nanase/YMF825-musicBOX/README.md

YMF825 musicBOX
==============

## 概要

Arduino Nano と YMF825Board を使って電子オルゴールを作るための回路とスケッチです。

## 基板一覧

バージョン | 開発時期
----------|---------------
[Ver.1.0a](./1.0a_2018.09/)<br>[Ver.1.0ka](./1.0a_2018.09/) | 2018.09

## ライセンス

### ソフトウェア

[**MIT LICENSE**](./LICENSE)

### ハードウェア

1. このリポジトリで公開されている基板情報、回路に限り、誰でも無償で無制限で扱ってよい。
2. このリポジトリで公開されている基板情報、回路の設計者および公開者はなんら責任を負わない。
