nanase/YMF825-musicBOX/1.1_2018.10/pdf/schematic.pdf

1

2

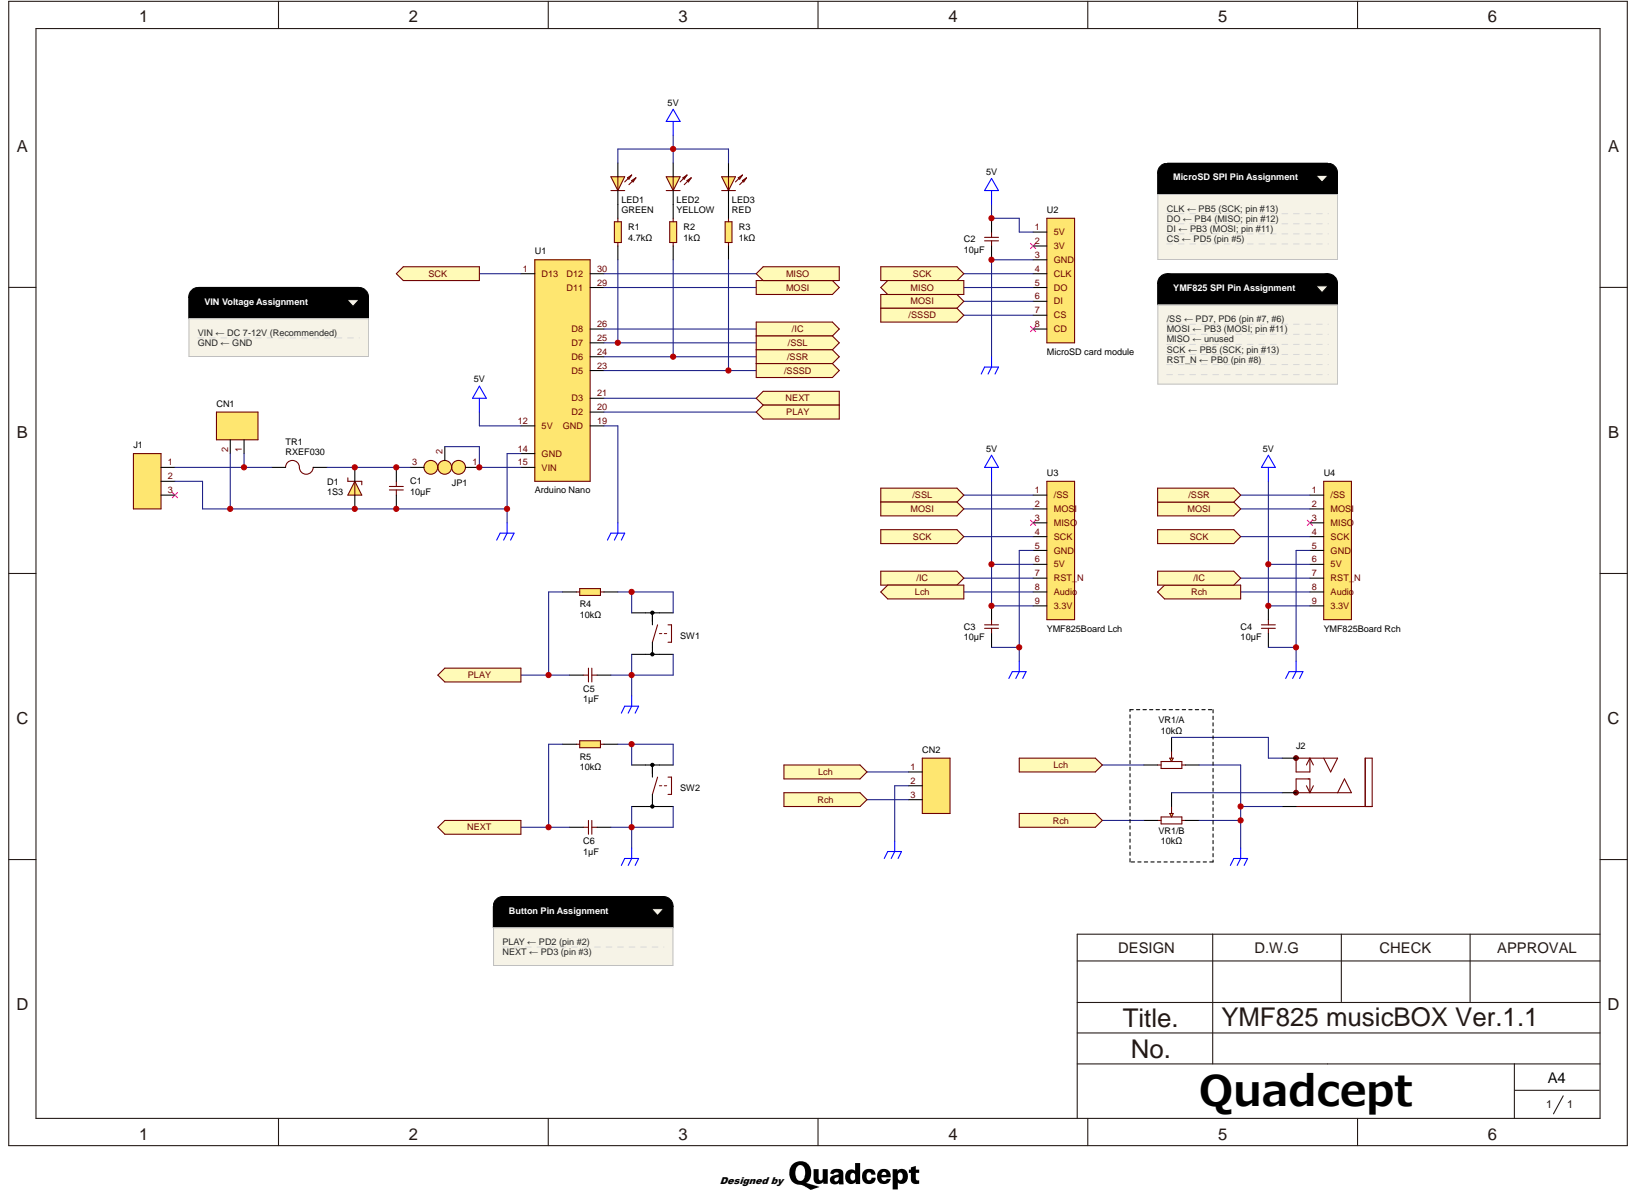
[picture p10: page 1]

MicroSD SPI Pin Assignment

Title. | YMF825 musicBOX Ver.1.1
No.
Quadcept | A4
