nanase/YMF825-musicBOX/1.0a_2018.09/pdf/schematic.pdf

1

2

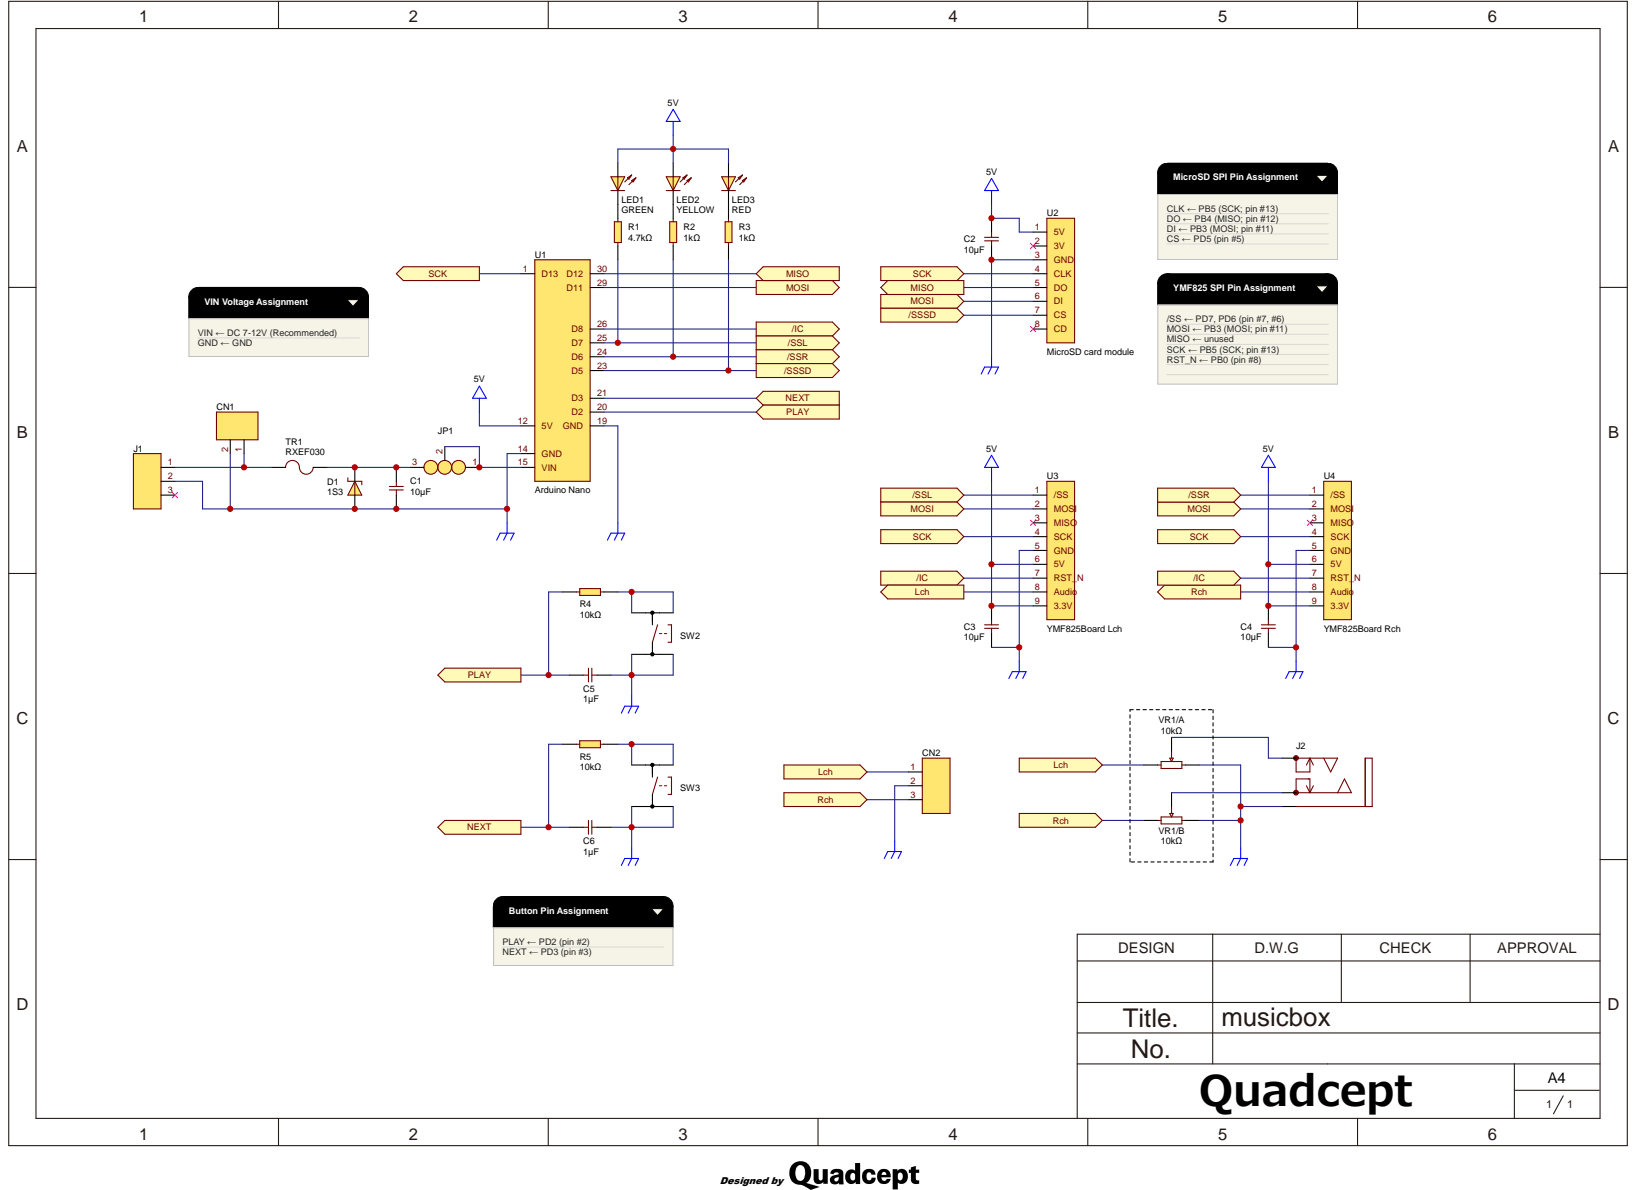
[picture p11: page 1]

MicroSD SPI Pin Assignment

Title. | musicbox
No.
Quadcept | A4
