nanase/YMF825-musicBOX/1.1_2018.10/pdf/pcb.pdf

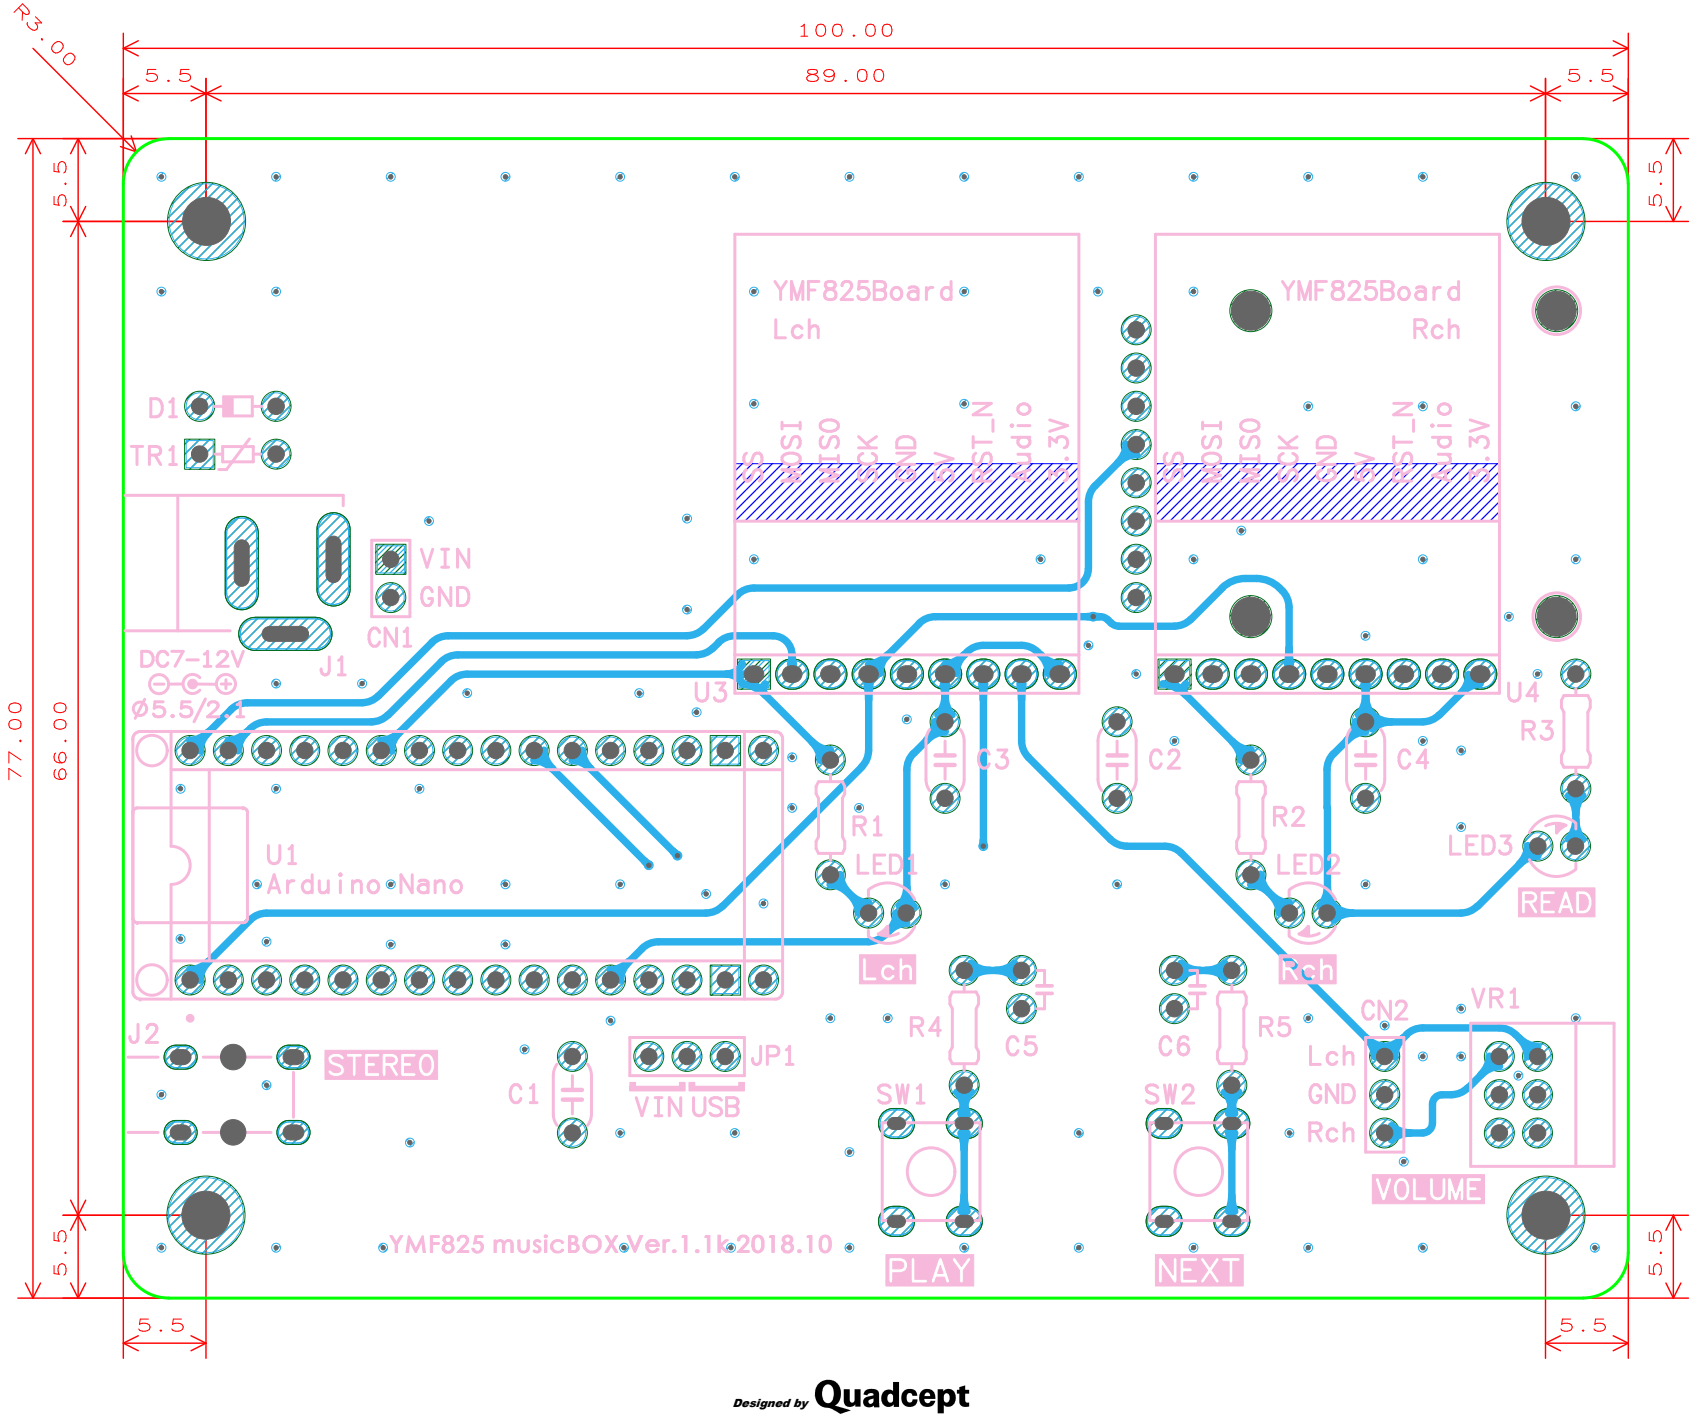
[picture p12: page 1]
Designed by

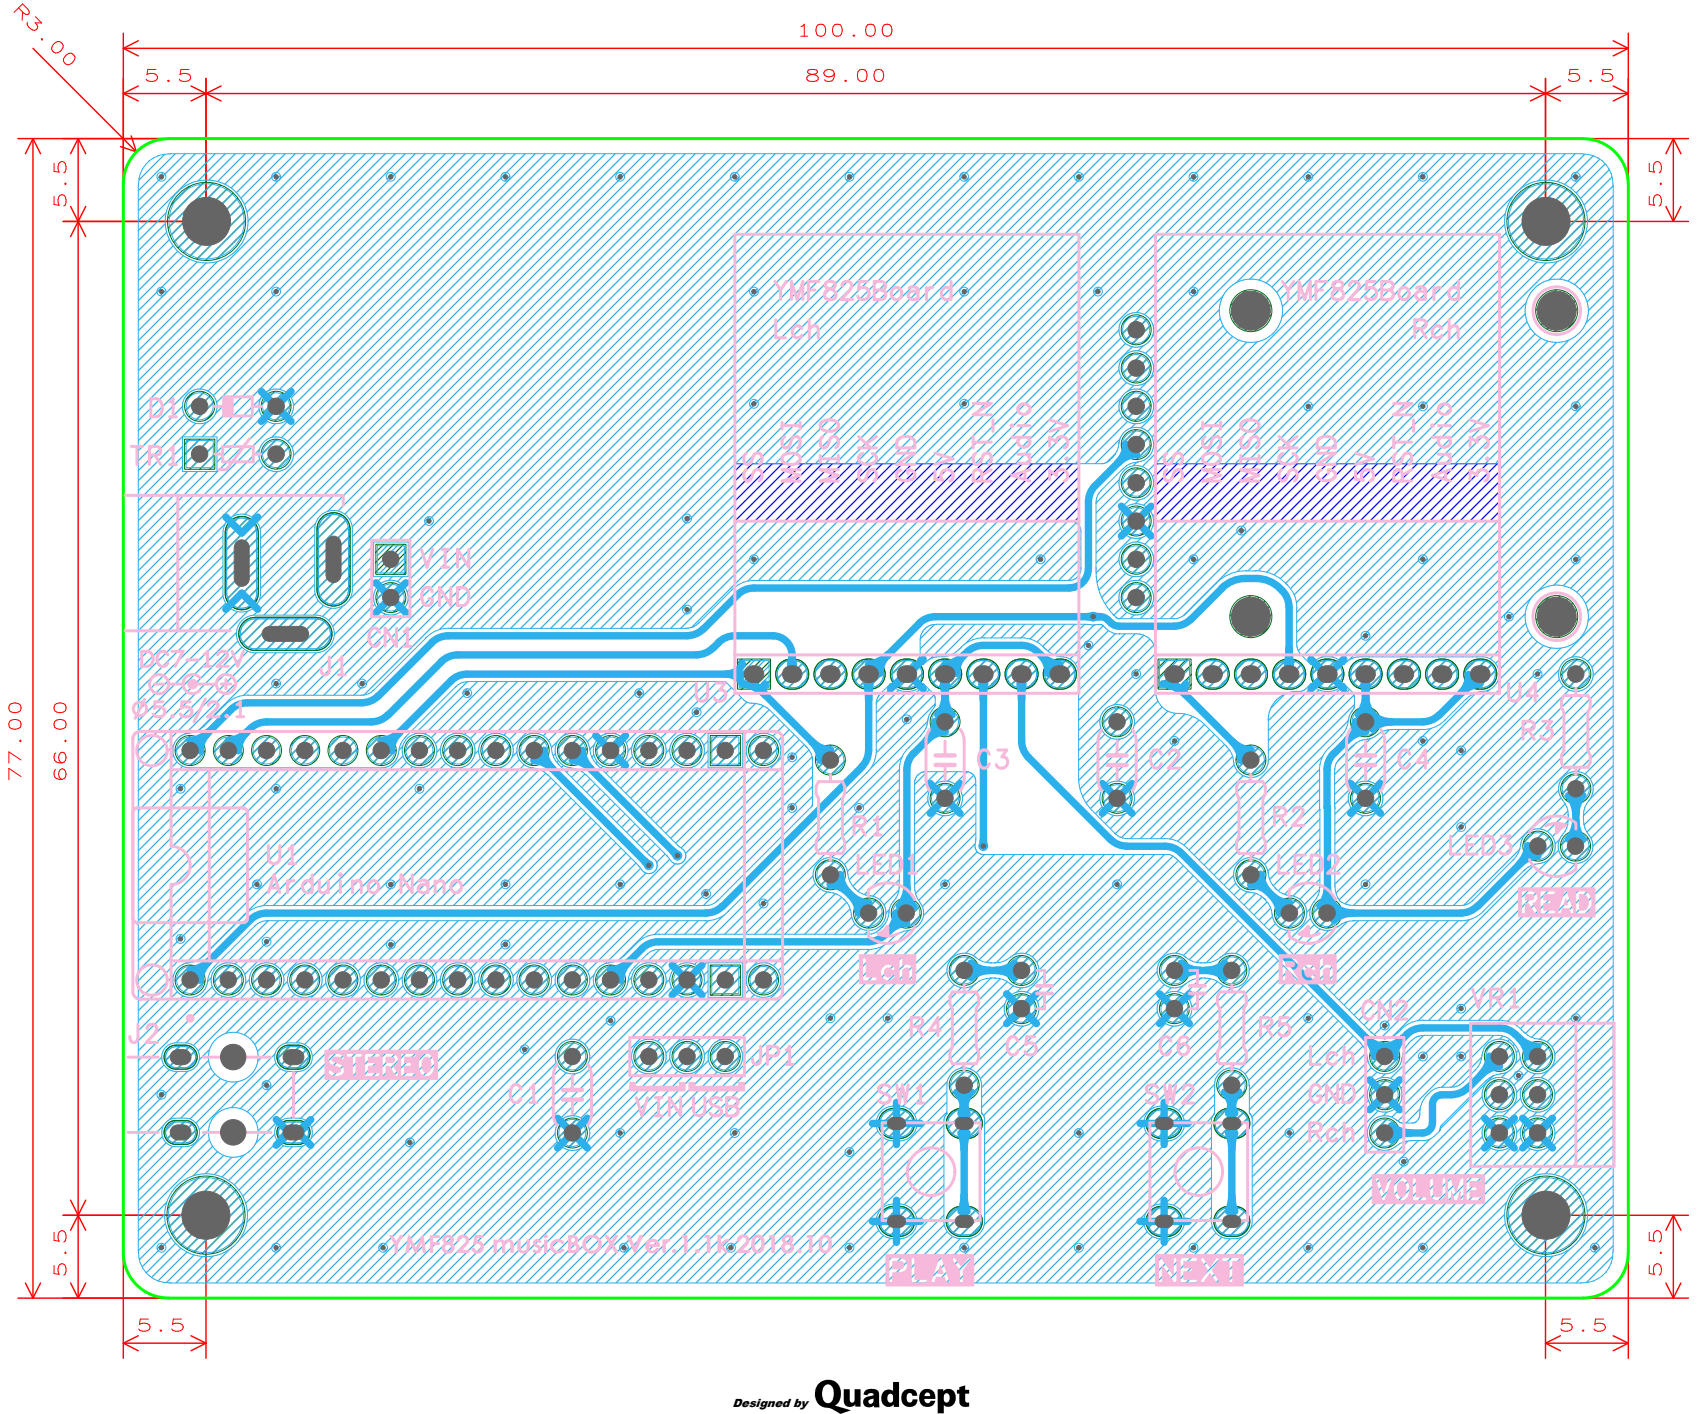
[picture p13: page 2]

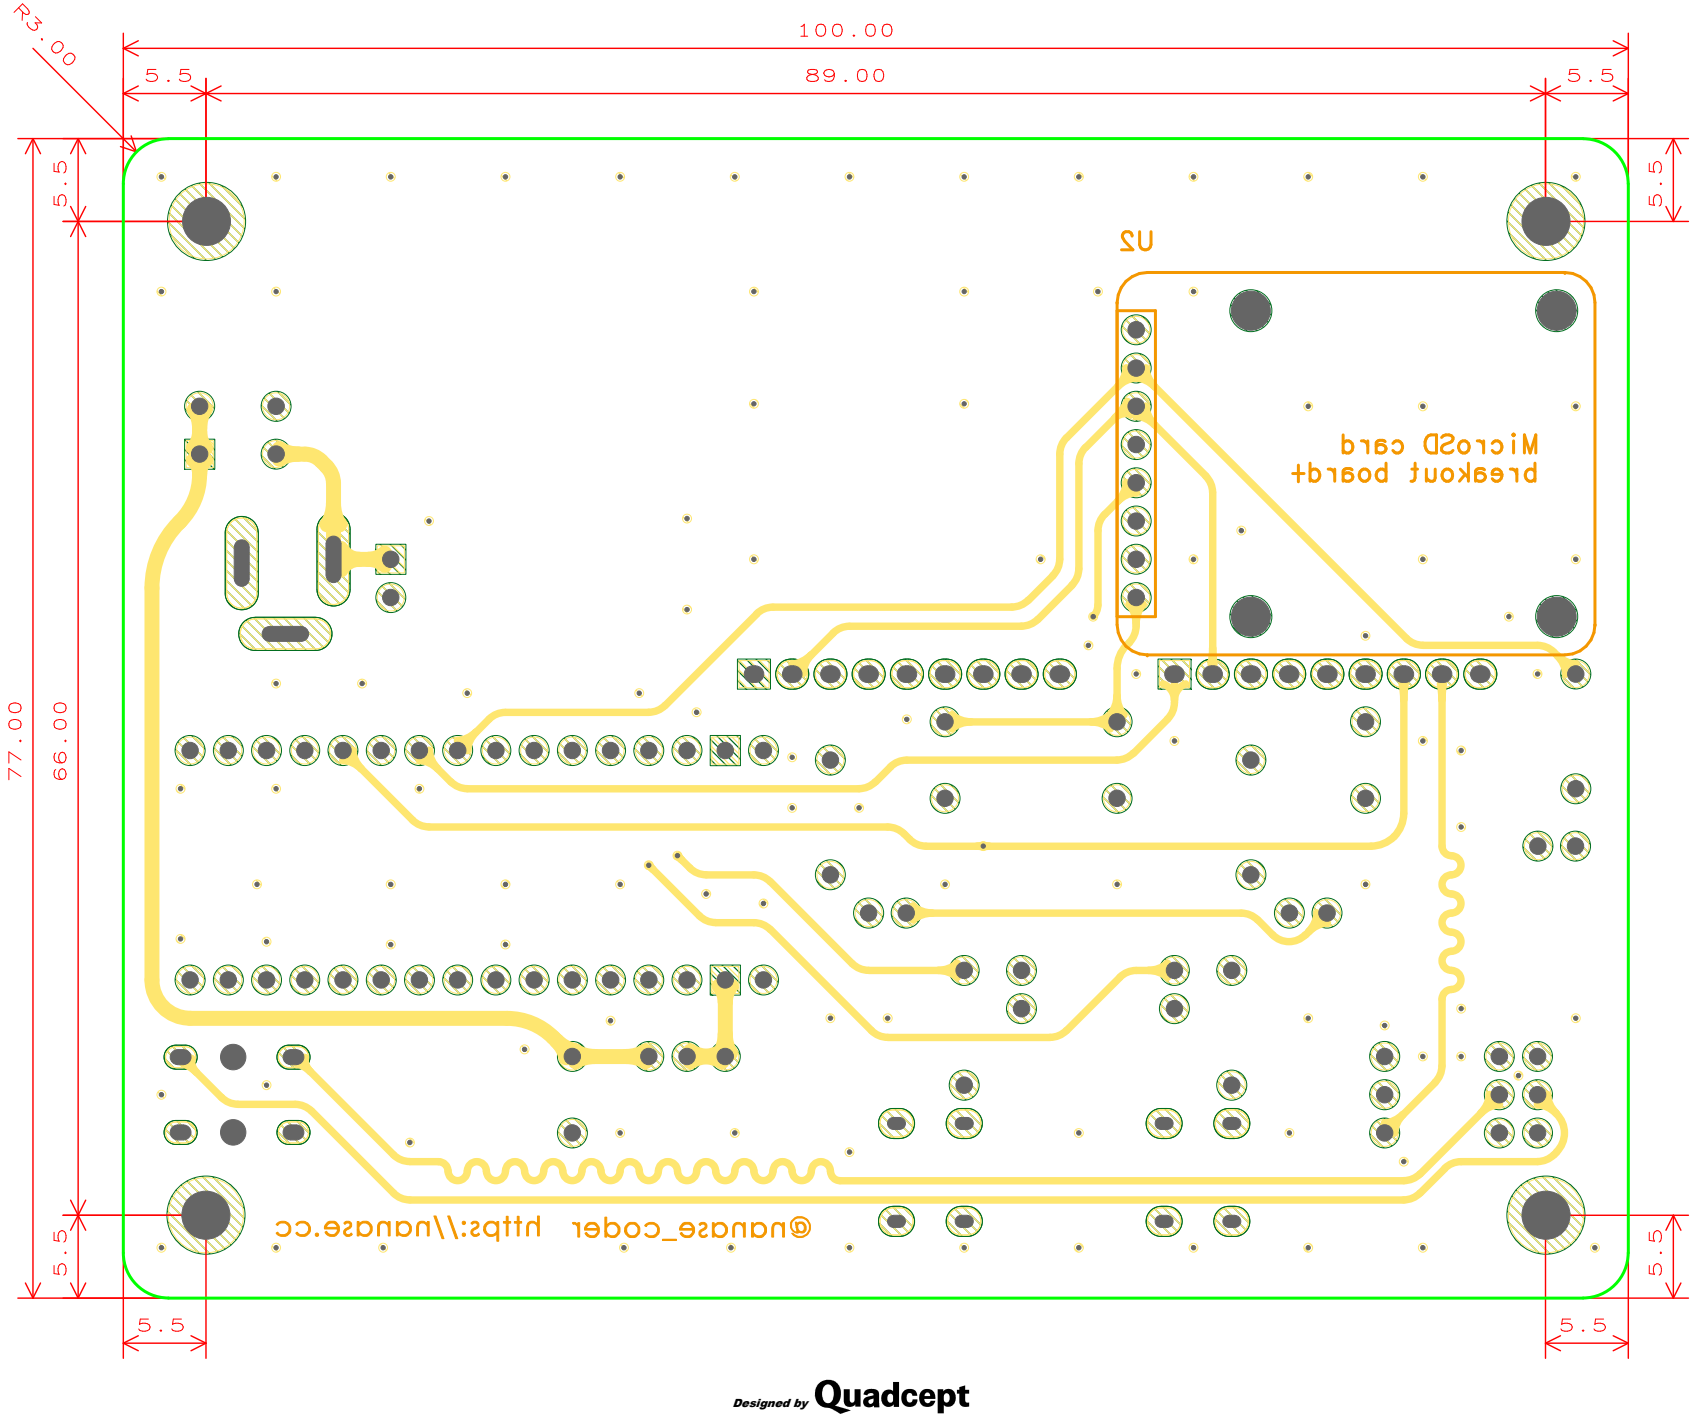
[picture p14: page 3]

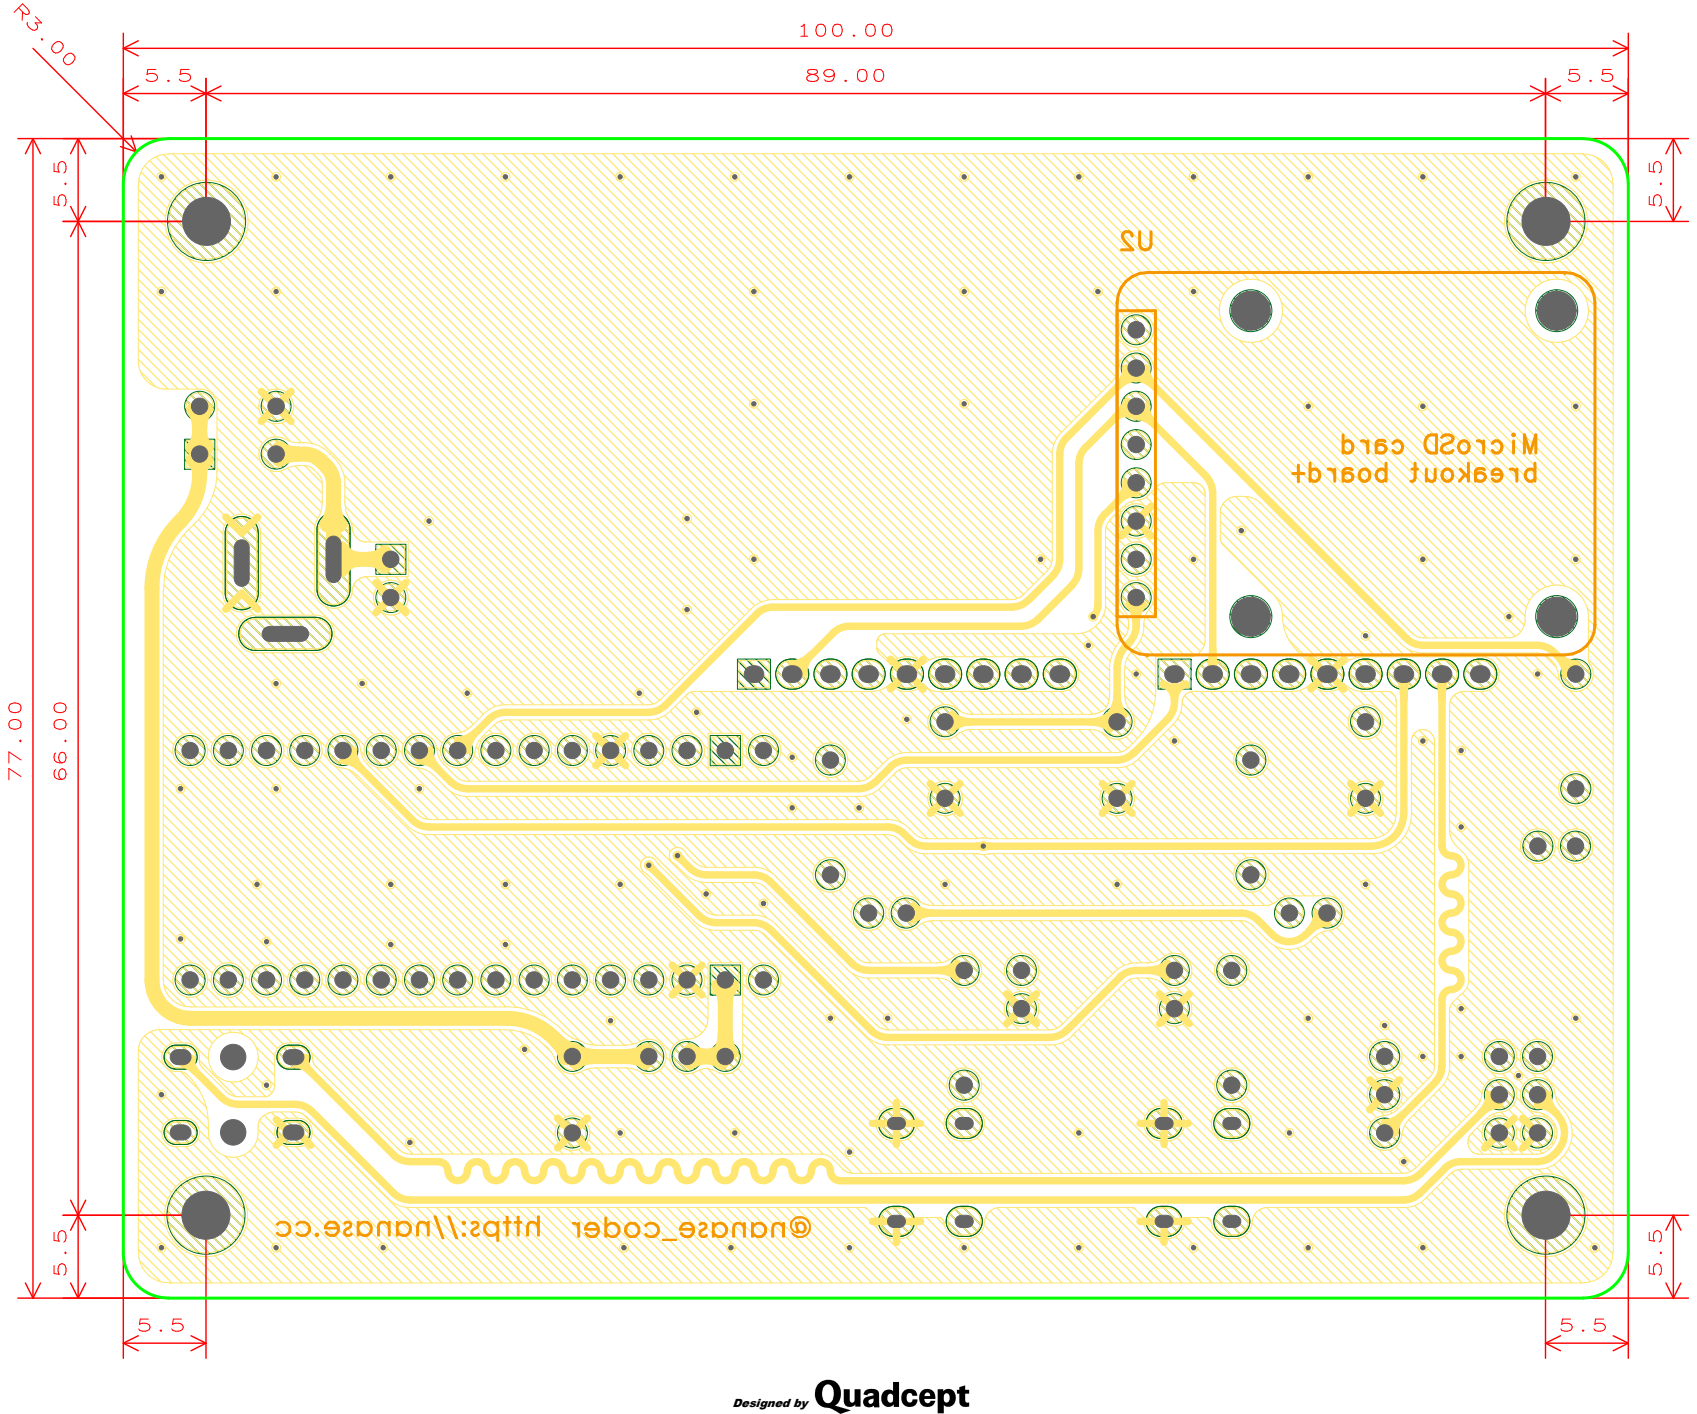
[picture p15: page 4]
