nanase/YMF825-musicBOX/1.0a_2018.09/pdf/pcb.pdf

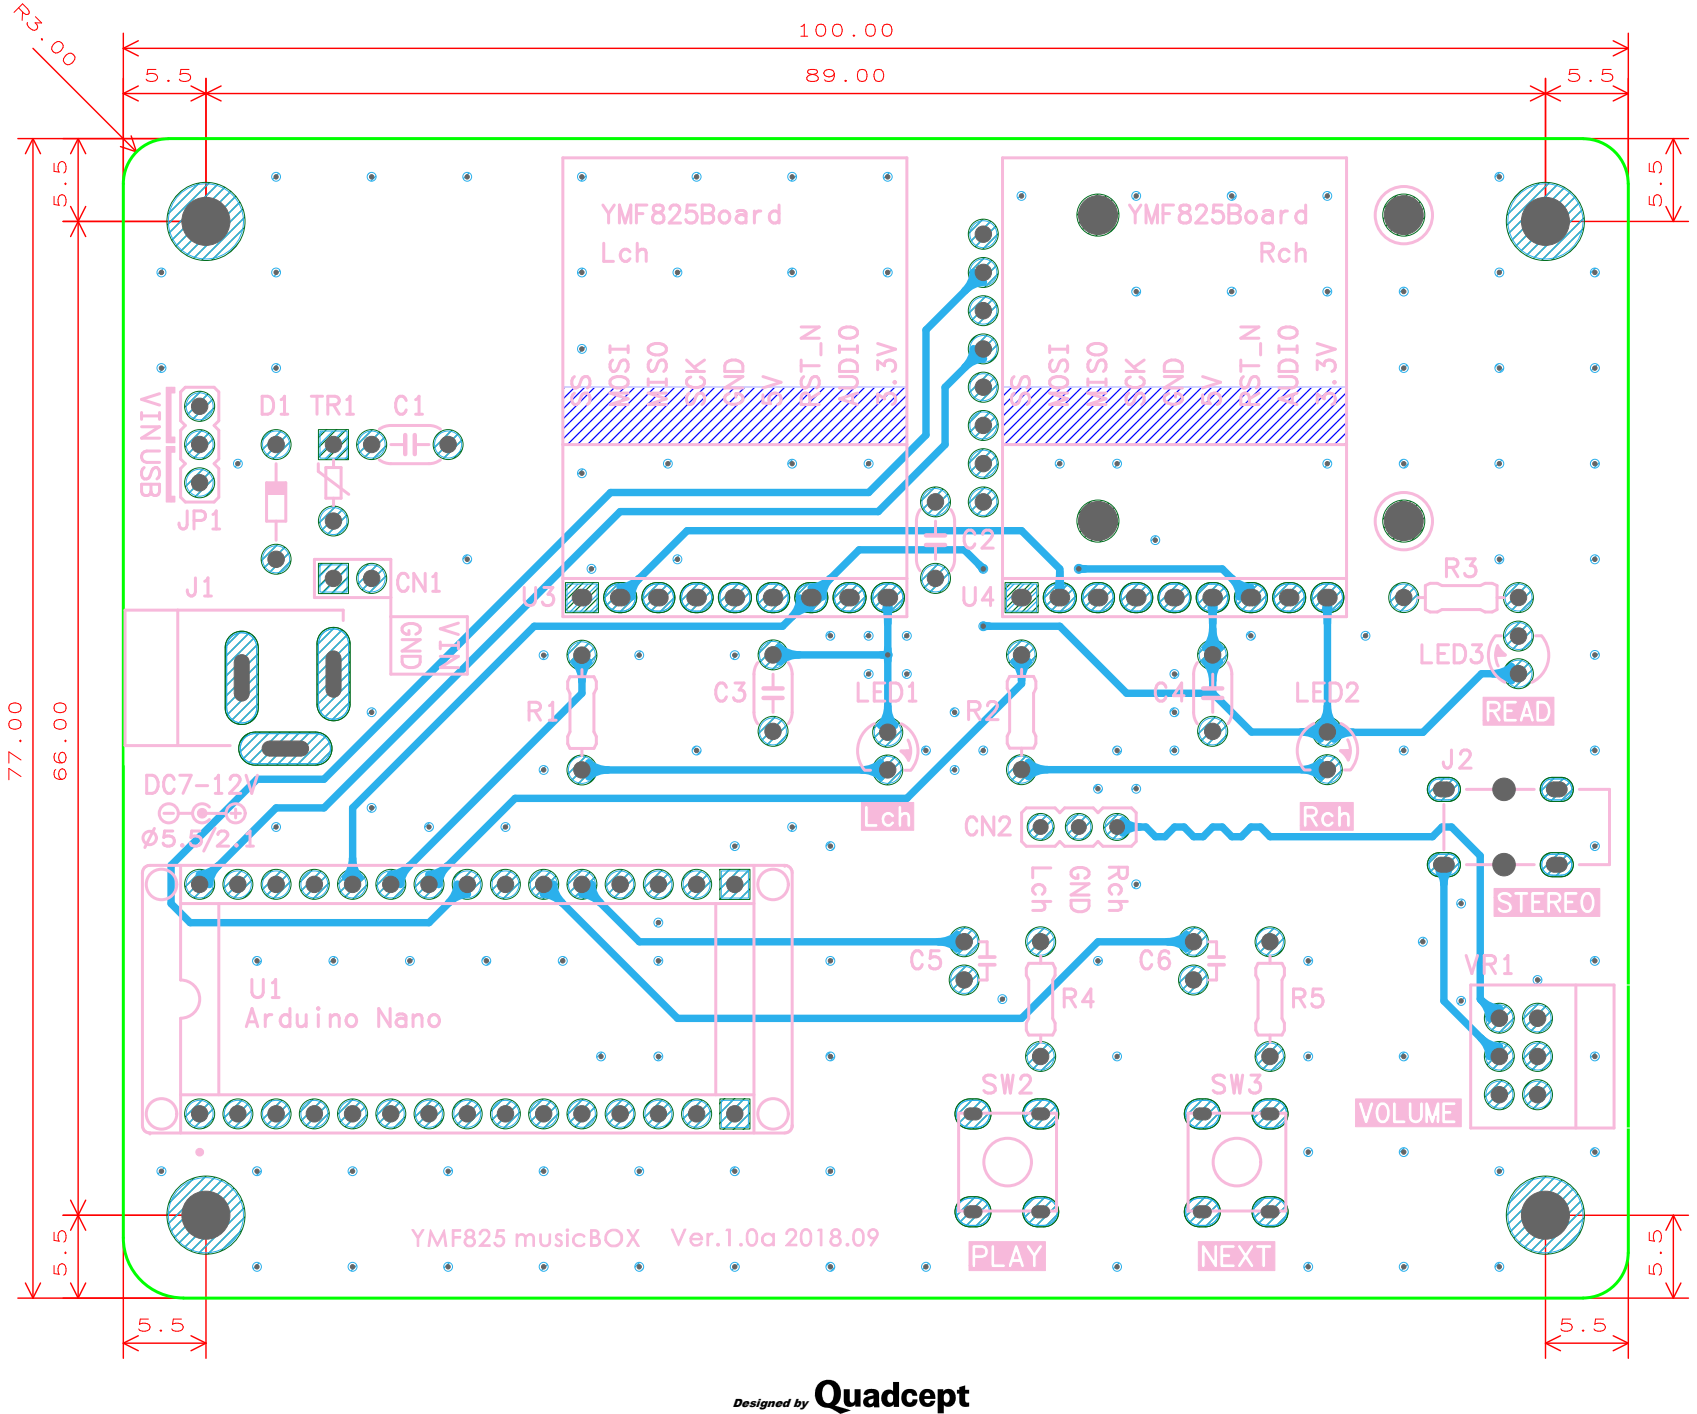
[picture p16: page 1]
Designed by

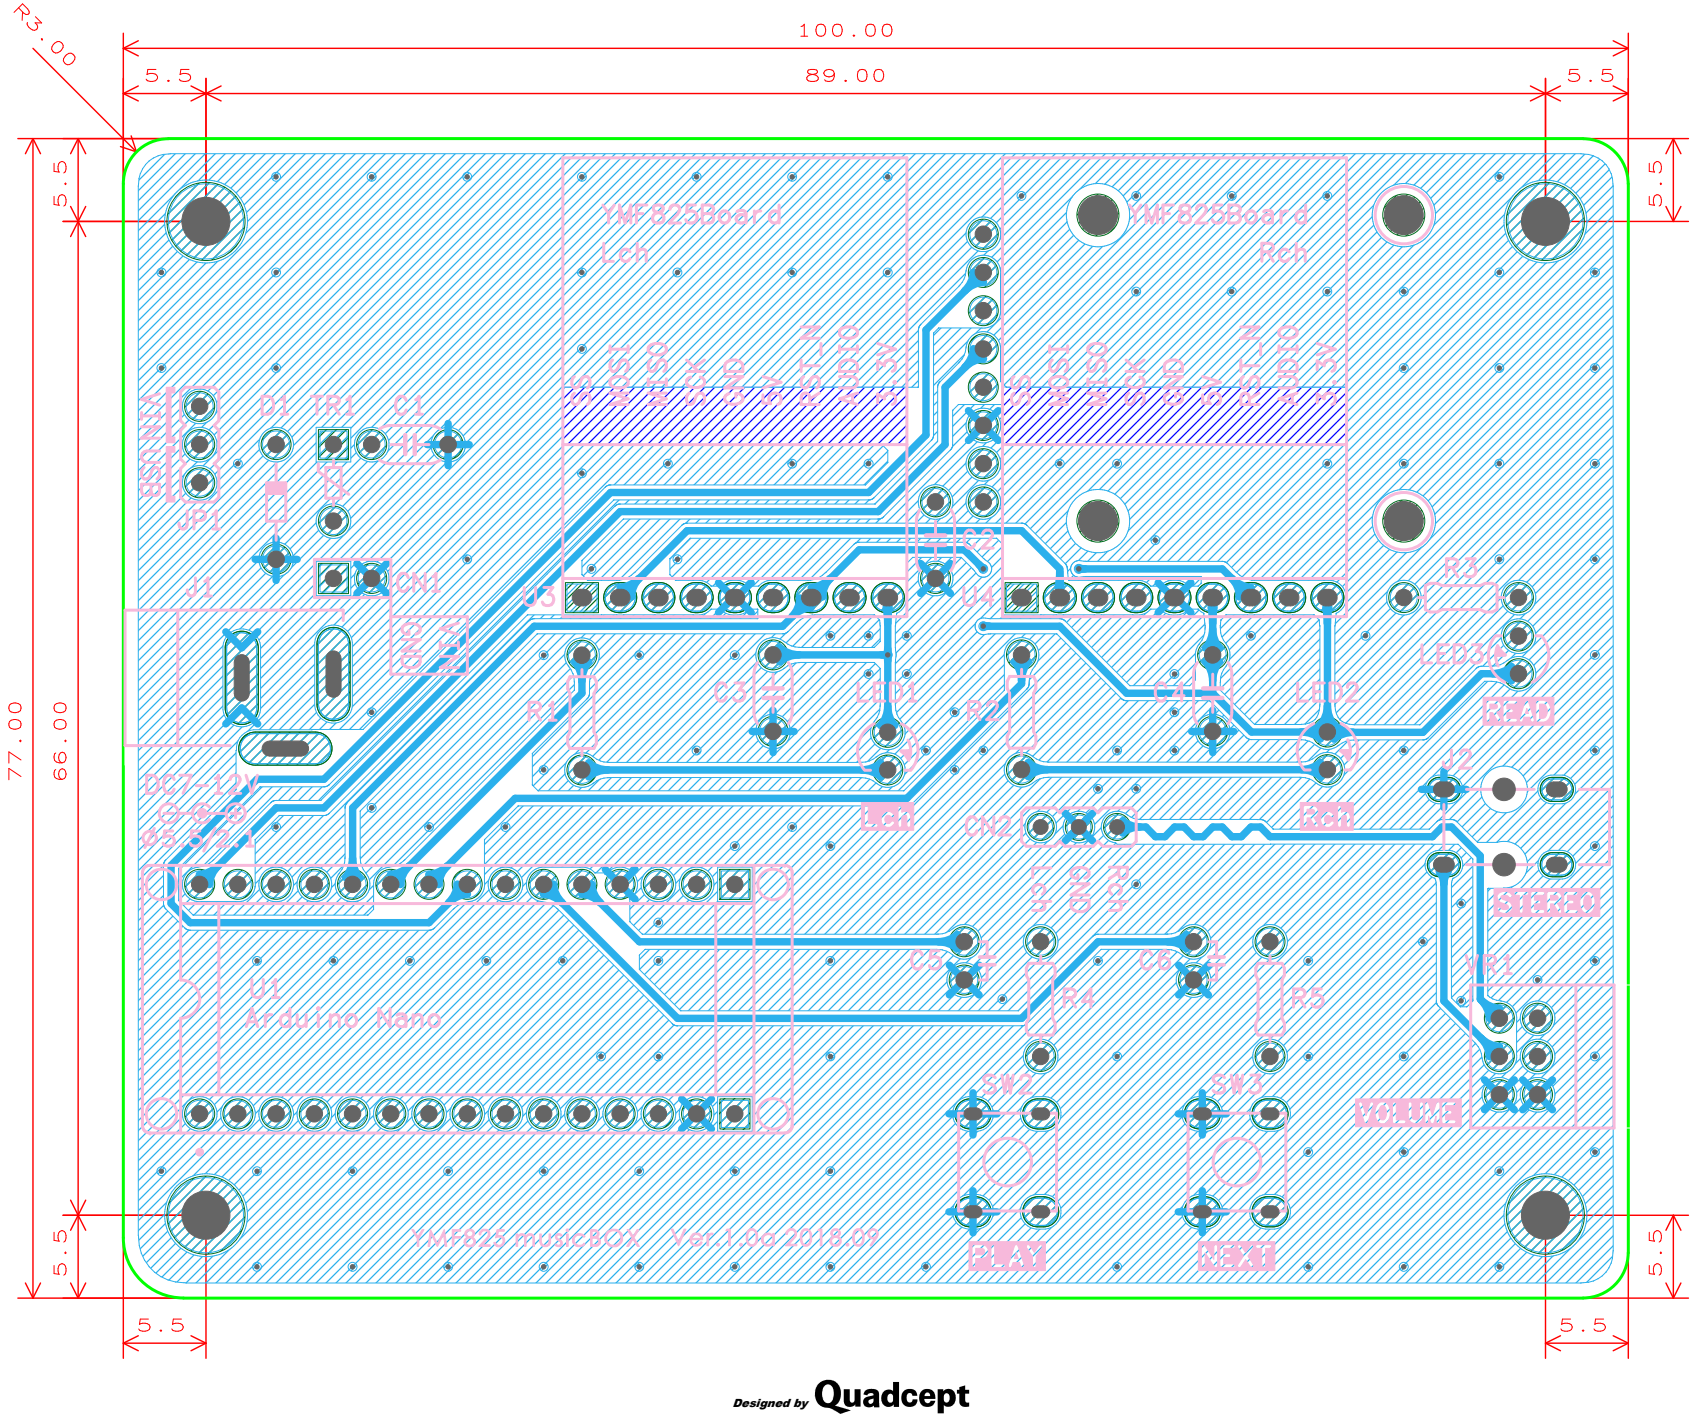
[picture p17: page 2]

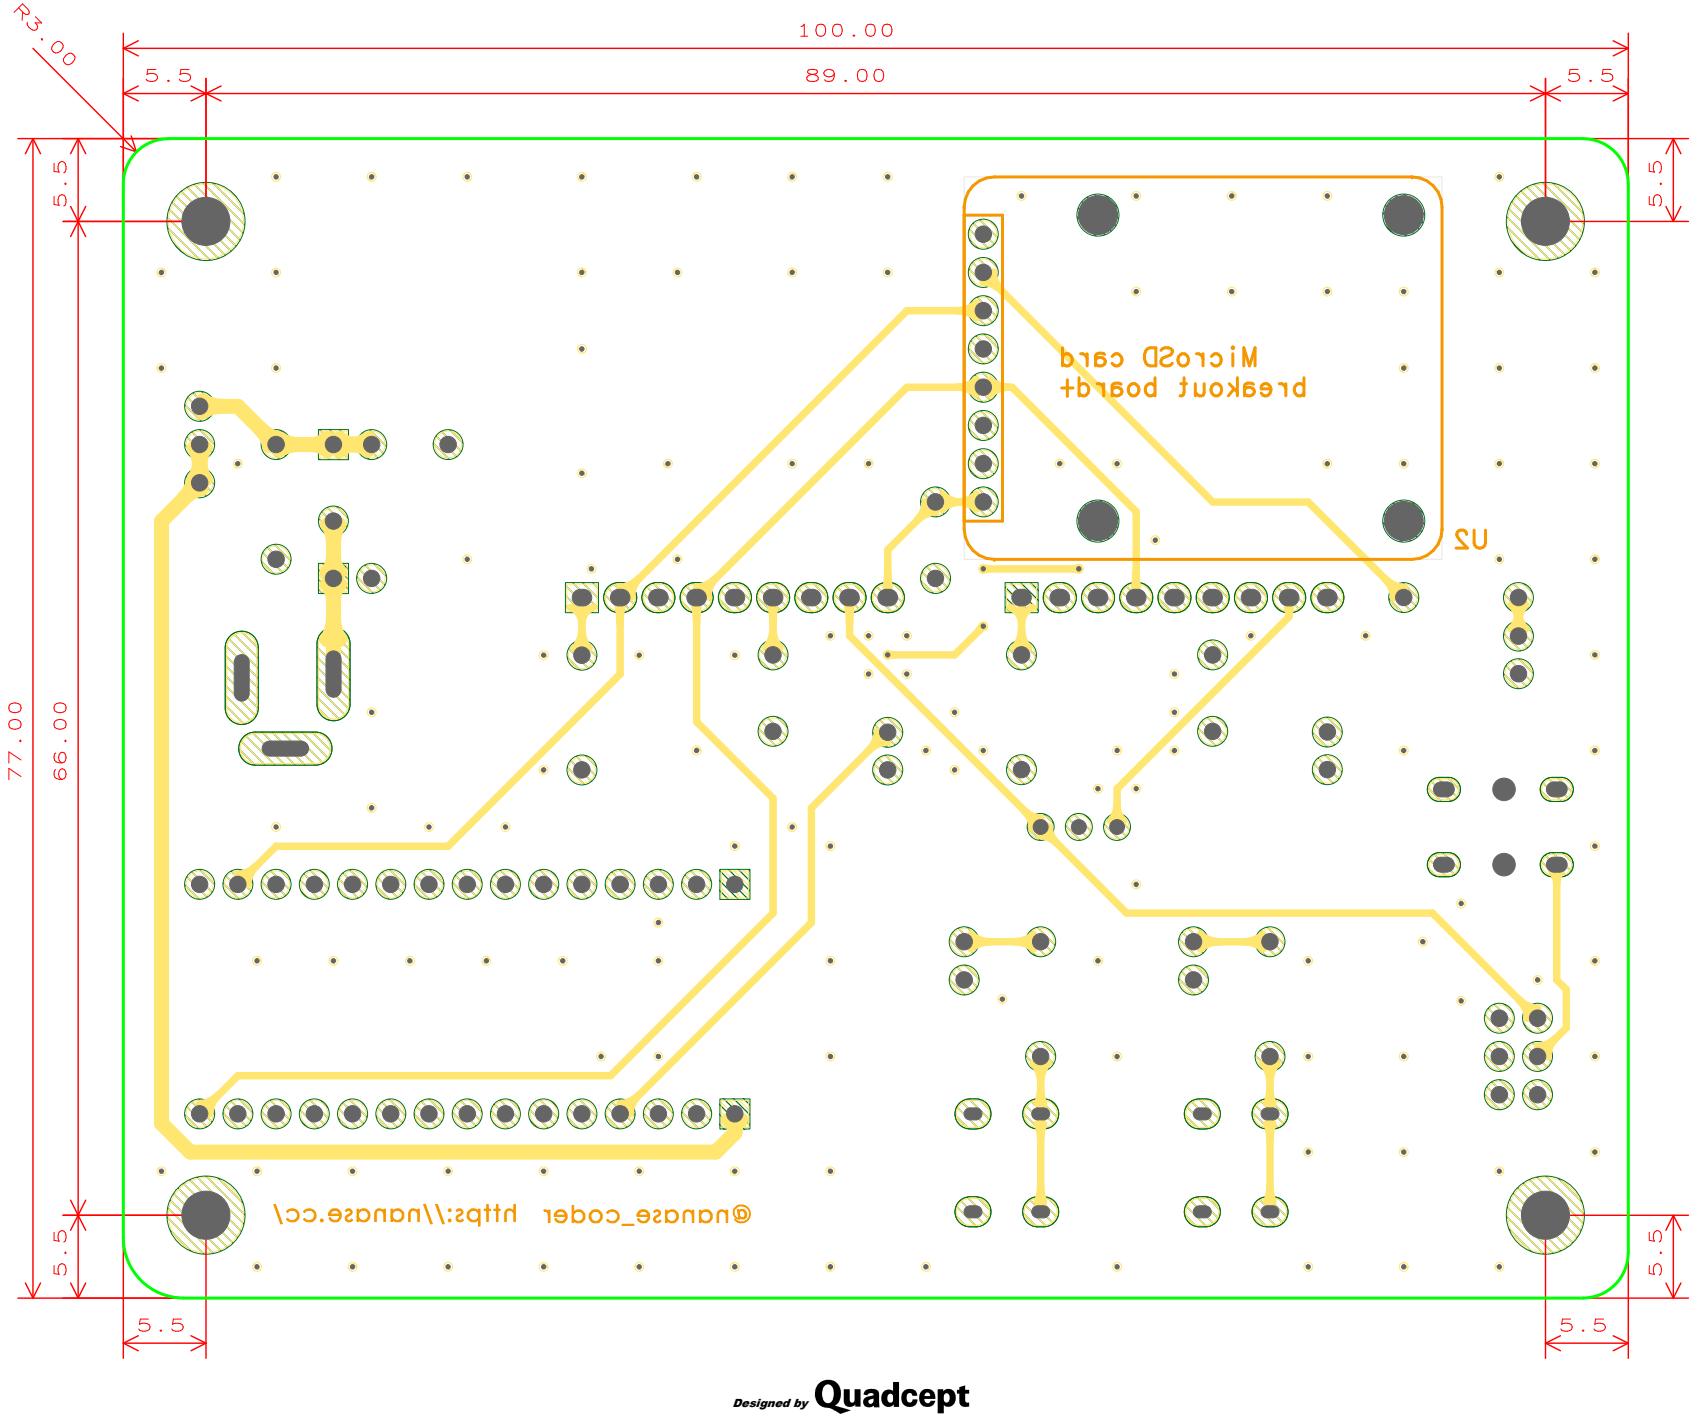
[picture p18: page 3]

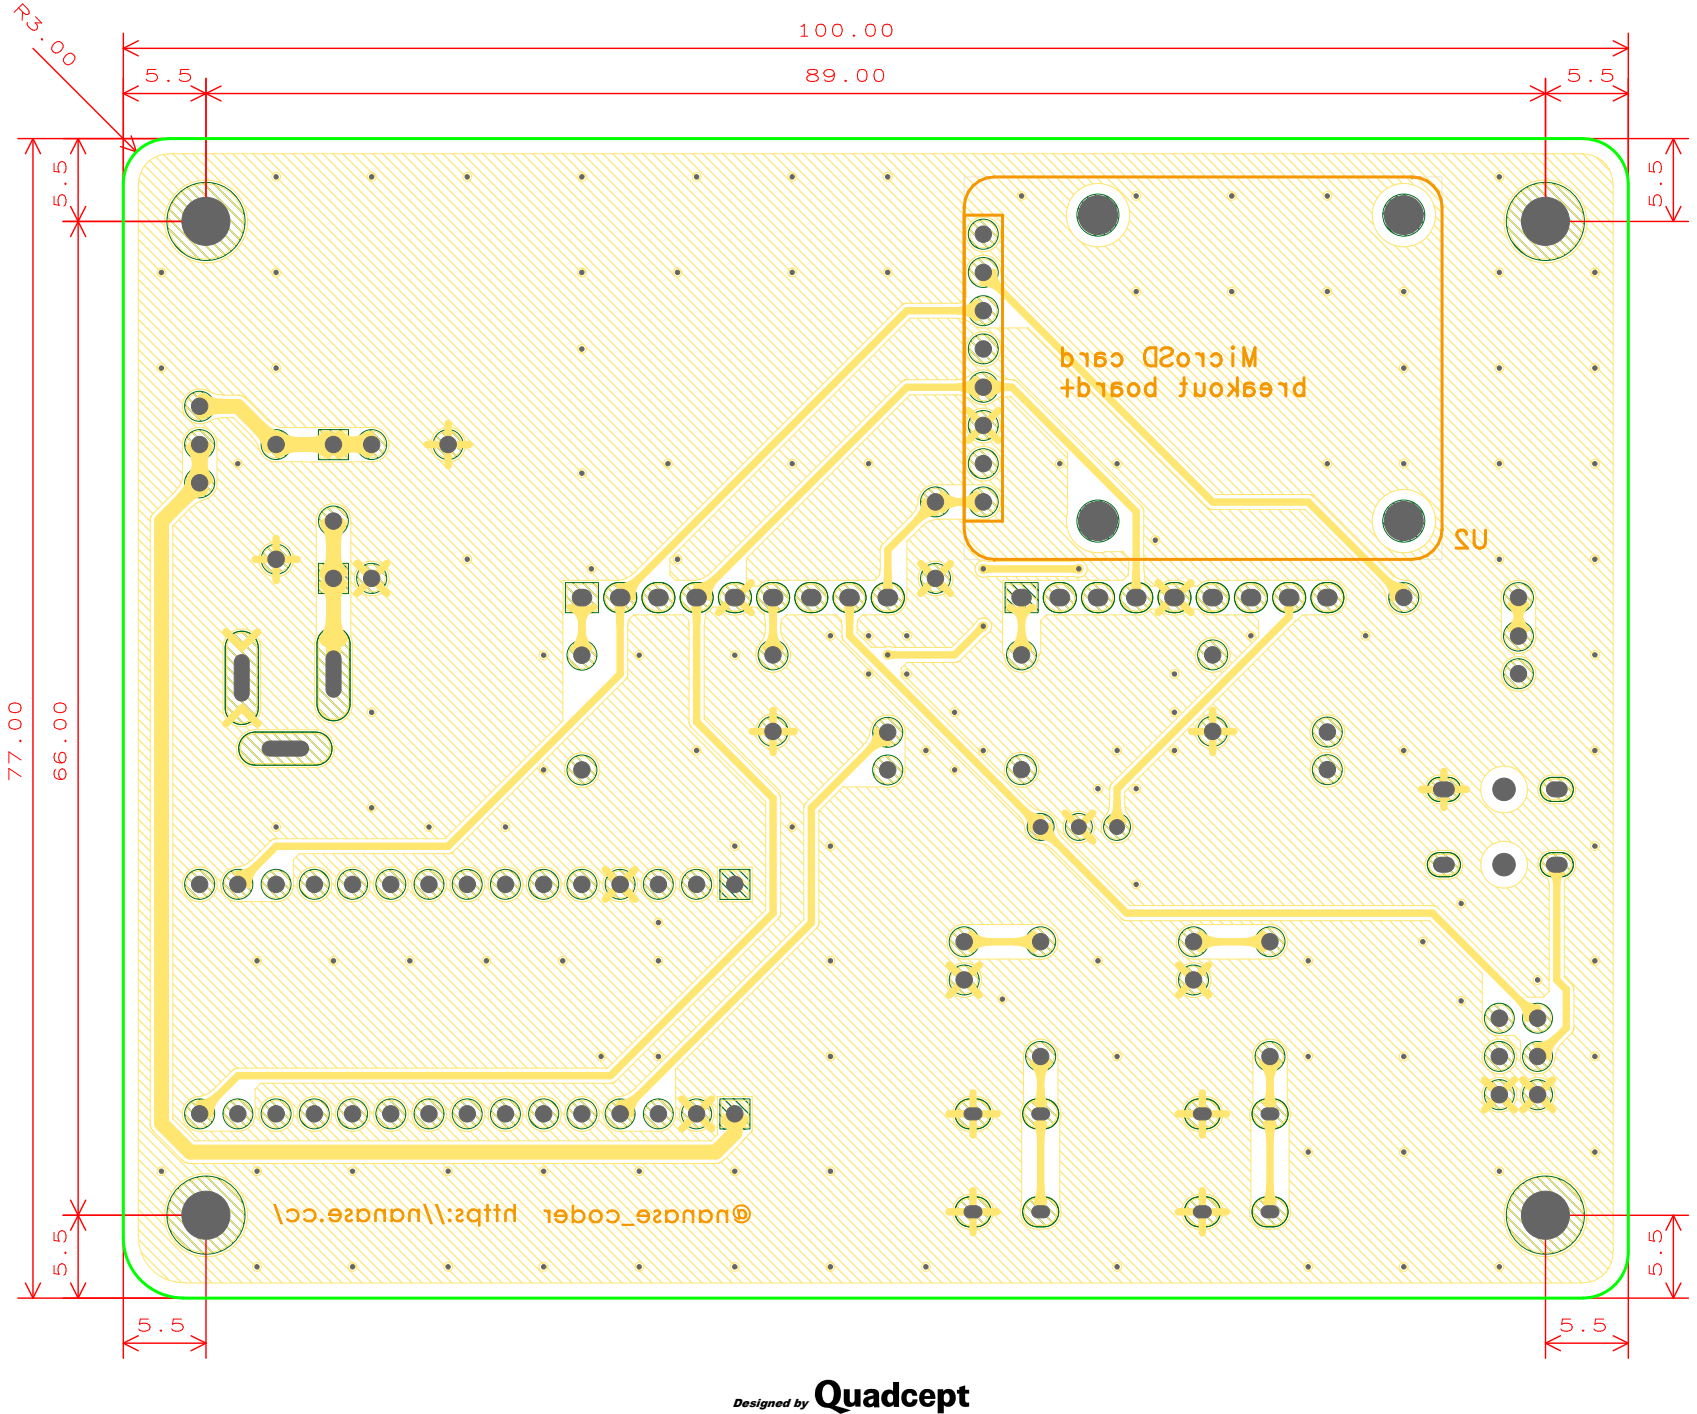
[picture p19: page 4]
