nanase/YMF825-musicBOX/(commit log)

2018-08-27 演奏終了時にバッファに古いデータが残っていた問題を修正 fix #1
2018-08-28 ディレクトリのrewind操作時にフリーズする問題を修正 fix #2
2018-08-28 未使用の関数を削除
2018-08-28 シリアル通信でデバッグメッセージを出すよう修正
2018-08-28 ファイル名のためのバッファを廃止
2018-08-28 戻り値の型の書き忘れを修正
2018-08-28 バッファ位置変数をグローバル変数に移動
2018-08-28 未使用の定数を削除
2018-08-28 バッファサイズの上限コメントを削除
2018-08-28 グローバル変数の宣言順序を変更
2018-08-28 命名規則を変更
2018-08-28 回路図とPCBのPDFを追加
2018-08-29 再生を一時停止したときにYMF825の全ボイスに対してNoteOffするよう変更
2018-08-29 回路図と基板図面のPNG画像を追加
2018-09-03 部品表を追加
2018-09-03 リンク間違いを修正
2018-09-04 曲の切り替え時のハードウェアリセットを削除
2018-09-07 拡張子に対する説明を追加
2018-09-07 Ver.1.0aの説明文を更新
2018-09-09 1.0aのREADMEを更新
2018-09-09 スケッチのREADMEを追加
2018-09-09 Ver.1.1のREADMEを追加
2018-09-30 SDカードの初期化に失敗した際に無限ループに入るよう修正
2018-10-01 ライブラリ PetitFatFs を使用
2018-10-01 ライブラリ PetitSerial を使用
2018-10-01 ディレクトリ終端に達したときに正しくディレクトリの初期位置に戻らない問題を修正
2018-10-16 SDカードの初期化失敗時に再試行するように変更
2018-10-16 Ver.1.1のREADMEを更新
2018-10-16 スケッチのREADMEを変更
2018-10-16 ソケットの写真を修正
2018-12-01 エラーメッセージの誤りを修正
2018-12-01 YMF825のハードウェアリセットを廃止
2019-01-09 ピンアサインを変更
2019-01-09 プルアップの定数指定を削除
2019-01-09 LCDを追加
2019-01-09 ymf825Initializeを追加
2019-01-19 JPMフォーマットを追加
2019-01-19 電源投入後70分で演奏が乱れる問題を修正
2019-01-19 オープニングを追加
2019-01-19 コーディング規約を作成
2019-01-19 decoder.inoをm25_decoder.inoに改名
2019-01-19 LCDの輝度変換テーブルを追加
2019-01-19 ファイルフォーマットチェックのフローを変更
2019-01-19 M25形式のデコーダを疎結合化
2019-01-19 PROGMEMの改名と再フォーマット
2019-01-19 デコーダの選曲処理をメインループに移動
2019-01-19 M25判別処理をM25Decoderクラスに移動
2019-01-19 M25形式の定数をヘッダファイルに分離
2019-01-19 JPMフォーマットのデコーダを追加
2019-01-20 LCDのLUTを削除
2019-01-20 オープニングのフェードスピードを削除
2019-01-20 演奏開始後にLCDのバックライトがスムーズに変化しない問題を修正
2019-01-20 sdio.inoの警告表示をdefinitions.hに移動
2019-01-20 設定項目をconfig.hに分離
2019-01-20 loop関数のpaused変数のstatic指定を削除
2019-01-20 includeをdefinitions.hに集約
2019-01-20 LCD ControlがWOPxとSELxに存在していて曖昧だったのを修正
2019-01-20 Markdownの再フォーマット
2019-01-20 JpmDecoderの関数を命名規則に従って改名
2019-01-20 sdReadBufferがリード成功可否を返すよう変更
2019-01-20 M25Decoderのswitchのフローを改良
2019-01-20 SDバッファの読み取り処理をマクロ化
2019-01-20 デバッグモードを追加
2019-01-20 SPIの初期化処理をspi.inoに分離
2019-01-27 ピンアサインの間違いを修正
2019-01-27 voidの関数で値を返却していたのを修正
2019-01-27 未使用の変数に対する警告を抑制
2019-01-27 型の警告を修正
2019-01-27 lcd.createCharの後にbeginを呼び出すよう修正
2019-01-27 オープニングのカスタム文字を追加
2019-01-30 JPMフォーマットのマジックナンバーを大文字に変更
2019-01-30 JPMフォーマットの拡張子判定の誤りを修正
2019-01-30 JPMフォーマットの判定時に正しくSDカードが読み込まれていなかった問題を修正
2019-01-30 トーンパラメータのBurstWrite時のLengthの計算方法の誤りを修正
2019-01-30 JpmDecoderのswitch文を整理
2019-01-30 マクロの引数にカッコがない問題を修正
2019-01-30 全チャネルのReleaseを個別のボイスに対して行っていた問題を修正
2019-01-30 次選曲時に消音するように変更
2019-03-01 JPMフォーマットが正しくデコードされない問題を修正
